12cmjg1/IDC_project/HARDWARE/usartx.c

#include "usartx.h"

PointDataProcessDef PointDataProcess[1200];//更新225个数据
LiDARFrameTypeDef Pack_Data;
PointDataProcessDef Dataprocess[1200];      //用于小车避障、跟随、走直线、ELE雷达避障的雷达数据

float Diff_Along_Distance_KP = -0.030f,Diff_Along_Distance_KD = -0.245f,Diff_Along_Distance_KI = -0.001f;	//差速小车走直线距离调整PID参数
float Akm_Along_Distance_KP = -0.115f*1000,Akm_Along_Distance_KD = -1000.245f*1000,Akm_Along_Distance_KI = -0.001f*1000;	//阿克曼走直线距离调整PID参数
float FourWheel_Along_Distance_KP = -0.115f*1000,FourWheel_Along_Distance_KD = -100.200f*1000,FourWheel_Along_Distance_KI = -0.001f*1000;	//四驱走直线距离调整PID参数
float Along_Distance_KP = 0.163f*1000,Along_Distance_KD = 0.123*1000,Along_Distance_KI = 0.001f*1000;	//麦轮和全向走直线距离调整PID参数

float Distance_KP = -0.150f,Distance_KD = -0.052f,Distance_KI = -0.001;	//跟随距离调整PID参数

float Follow_KP = -2.566f,Follow_KD = -1.368f,Follow_KI = -0.001f;  //转向PID
float Follow_KP_Akm = -0.550f,Follow_KD_Akm = -0.121f,Follow_KI_Akm = -0.001f;

/**************************************************************************
Function: Serial port 1 initialization
Input   : none
Output  : none
函数功能：串口1初始化
入口参数：无
返 回 值：无
**************************************************************************/
void uart1_init(u32 bound)
{  	 
	GPIO_InitTypeDef GPIO_InitStructure;
	USART_InitTypeDef USART_InitStructure;
	NVIC_InitTypeDef NVIC_InitStructure;
	
	RCC_AHB1PeriphClockCmd(RCC_AHB1Periph_GPIOA, ENABLE);	 //Enable the gpio clock //使能GPIO时钟
	RCC_APB2PeriphClockCmd(RCC_APB2Periph_USART1, ENABLE); //Enable the Usart clock //使能USART时钟

	GPIO_PinAFConfig(GPIOA,GPIO_PinSource9,GPIO_AF_USART1);	
	GPIO_PinAFConfig(GPIOA,GPIO_PinSource10 ,GPIO_AF_USART1);	 
	
	GPIO_InitStructure.GPIO_Pin = GPIO_Pin_9|GPIO_Pin_10;
	GPIO_InitStructure.GPIO_Mode=GPIO_Mode_AF;            //输出模式
	GPIO_InitStructure.GPIO_OType=GPIO_OType_PP;          //推挽输出
	GPIO_InitStructure.GPIO_Speed=GPIO_Speed_50MHz;       //高速50MHZ
	GPIO_InitStructure.GPIO_PuPd=GPIO_PuPd_UP;            //上拉
	GPIO_Init(GPIOA, &GPIO_InitStructure);  		          //初始化
	
  //UsartNVIC configuration //UsartNVIC配置
	NVIC_InitStructure.NVIC_IRQChannel = USART1_IRQn;
	//Preempt priority //抢占优先级
	NVIC_InitStructure.NVIC_IRQChannelPreemptionPriority=1 ;
	//Subpriority //子优先级
	NVIC_InitStructure.NVIC_IRQChannelSubPriority = 0;		
	//Enable the IRQ channel //IRQ通道使能
	NVIC_InitStructure.NVIC_IRQChannelCmd = ENABLE;	
  //Initialize the VIC register with the specified parameters 
	//根据指定的参数初始化VIC寄存器	
	NVIC_Init(&NVIC_InitStructure);	
	
  //USART Initialization Settings 初始化设置
	USART_InitStructure.USART_BaudRate = bound; //Port rate //串口波特率
	USART_InitStructure.USART_WordLength = USART_WordLength_8b; //The word length is 8 bit data format //字长为8位数据格式
	USART_InitStructure.USART_StopBits = USART_StopBits_1; //A stop bit //一个停止位
	USART_InitStructure.USART_Parity = USART_Parity_No; //Prosaic parity bits //无奇偶校验位
	USART_InitStructure.USART_HardwareFlowControl = USART_HardwareFlowControl_None; //No hardware data flow control //无硬件数据流控制
	USART_InitStructure.USART_Mode = USART_Mode_Rx | USART_Mode_Tx;	//Sending and receiving mode //收发模式
	USART_Init(USART1, &USART_InitStructure); //Initialize serial port 1 //初始化串口1
	
	USART_ITConfig(USART1, USART_IT_RXNE, ENABLE); //Open the serial port to accept interrupts //开启串口接受中断
	USART_Cmd(USART1, ENABLE);                     //Enable serial port 1 //使能串口1
}
/**************************************************************************
Function: Serial port 2 initialization
Input   : none
Output  : none
函数功能：串口2初始化
入口参数：无
返回  值：无
**************************************************************************/
void uart2_init(u32 bound)
{  	 
	GPIO_InitTypeDef GPIO_InitStructure;
	USART_InitTypeDef USART_InitStructure;
	NVIC_InitTypeDef NVIC_InitStructure;

	RCC_AHB1PeriphClockCmd(RCC_AHB1Periph_GPIOD, ENABLE);	 //Enable the gpio clock  //使能GPIO时钟
	RCC_APB1PeriphClockCmd(RCC_APB1Periph_USART2, ENABLE); //Enable the Usart clock //使能USART时钟
	
	GPIO_PinAFConfig(GPIOD,GPIO_PinSource5,GPIO_AF_USART2);	
	GPIO_PinAFConfig(GPIOD,GPIO_PinSource6 ,GPIO_AF_USART2);	 
	
	GPIO_InitStructure.GPIO_Pin = GPIO_Pin_5|GPIO_Pin_6;
	GPIO_InitStructure.GPIO_Mode=GPIO_Mode_AF;            //输出模式
	GPIO_InitStructure.GPIO_OType=GPIO_OType_PP;          //推挽输出
	GPIO_InitStructure.GPIO_Speed=GPIO_Speed_50MHz;       //高速50MHZ
	GPIO_InitStructure.GPIO_PuPd=GPIO_PuPd_UP;            //上拉
	GPIO_Init(GPIOD, &GPIO_InitStructure);  		          //初始化
	
	//UsartNVIC configuration //UsartNVIC配置
	NVIC_InitStructure.NVIC_IRQChannel = USART2_IRQn;
	//Preempt priority //抢占优先级
	NVIC_InitStructure.NVIC_IRQChannelPreemptionPriority=1 ;
	//Subpriority //子优先级
	NVIC_InitStructure.NVIC_IRQChannelSubPriority = 0;	
  //Enable the IRQ channel //IRQ通道使能	
	NVIC_InitStructure.NVIC_IRQChannelCmd = ENABLE;
  //Initialize the VIC register with the specified parameters 
	//根据指定的参数初始化VIC寄存器		
	NVIC_Init(&NVIC_InitStructure);	
	
	//USART Initialization Settings 初始化设置
	USART_InitStructure.USART_BaudRate = bound; //Port rate //串口波特率
	USART_InitStructure.USART_WordLength = USART_WordLength_8b; //The word length is 8 bit data format //字长为8位数据格式
	USART_InitStructure.USART_StopBits = USART_StopBits_1; //A stop bit //一个停止
	USART_InitStructure.USART_Parity = USART_Parity_No; //Prosaic parity bits //无奇偶校验位
	USART_InitStructure.USART_HardwareFlowControl = USART_HardwareFlowControl_None; //No hardware data flow control //无硬件数据流控制
	USART_InitStructure.USART_Mode = USART_Mode_Rx | USART_Mode_Tx;	//Sending and receiving mode //收发模式
	USART_Init(USART2, &USART_InitStructure);      //Initialize serial port 2 //初始化串口2
	
	USART_ITConfig(USART2, USART_IT_RXNE, ENABLE); //Open the serial port to accept interrupts //开启串口接受中断
	USART_Cmd(USART2, ENABLE);                     //Enable serial port 2 //使能串口2 
}
/**************************************************************************
Function: Serial port 5 initialization
Input   : none
Output  : none
函数功能：串口5初始化
入口参数：无
返回  值：无
**************************************************************************/
void uart5_init(u32 bound)
{  	 
  GPIO_InitTypeDef GPIO_InitStructure;
	USART_InitTypeDef USART_InitStructure;
	NVIC_InitTypeDef NVIC_InitStructure;
	
	//PC12 TX
	RCC_AHB1PeriphClockCmd(RCC_AHB1Periph_GPIOC, ENABLE);	 //Enable the gpio clock  //使能GPIO时钟
	//PD2 RX
	RCC_AHB1PeriphClockCmd(RCC_AHB1Periph_GPIOD, ENABLE);	 //Enable the gpio clock  //使能GPIO时钟
  RCC_APB1PeriphClockCmd(RCC_APB1Periph_UART5, ENABLE); //Enable the Usart clock //使能USART时钟

	GPIO_PinAFConfig(GPIOC,GPIO_PinSource12,GPIO_AF_UART5);	
	GPIO_PinAFConfig(GPIOD,GPIO_PinSource2 ,GPIO_AF_UART5);	 
	
	GPIO_InitStructure.GPIO_Pin = GPIO_Pin_12;
	GPIO_InitStructure.GPIO_Mode=GPIO_Mode_AF;            //输出模式
	GPIO_InitStructure.GPIO_OType=GPIO_OType_PP;          //推挽输出
	GPIO_InitStructure.GPIO_Speed=GPIO_Speed_50MHz;       //高速50MHZ
	GPIO_InitStructure.GPIO_PuPd=GPIO_PuPd_UP;            //上拉
	GPIO_Init(GPIOC, &GPIO_InitStructure);  		          //初始化

	GPIO_InitStructure.GPIO_Pin = GPIO_Pin_2;
	GPIO_InitStructure.GPIO_Mode=GPIO_Mode_AF;            //输出模式
	GPIO_InitStructure.GPIO_OType=GPIO_OType_PP;          //推挽输出
	GPIO_InitStructure.GPIO_Speed=GPIO_Speed_50MHz;       //高速50MHZ
	GPIO_InitStructure.GPIO_PuPd=GPIO_PuPd_UP;            //上拉
	GPIO_Init(GPIOD, &GPIO_InitStructure);  		          //初始化
	
  //UsartNVIC configuration //UsartNVIC配置
  NVIC_InitStructure.NVIC_IRQChannel = UART5_IRQn;
	//Preempt priority //抢占优先级
	NVIC_InitStructure.NVIC_IRQChannelPreemptionPriority=2 ;
	//Preempt priority //抢占优先级
	NVIC_InitStructure.NVIC_IRQChannelSubPriority = 0;		
	//Enable the IRQ channel //IRQ通道使能	
	NVIC_InitStructure.NVIC_IRQChannelCmd = ENABLE;	
  //Initialize the VIC register with the specified parameters 
	//根据指定的参数初始化VIC寄存器		
	NVIC_Init(&NVIC_InitStructure);
	
  //USART Initialization Settings 初始化设置
	USART_InitStructure.USART_BaudRate = bound; //Port rate //串口波特率
	USART_InitStructure.USART_WordLength = USART_WordLength_8b; //The word length is 8 bit data format //字长为8位数据格式
	USART_InitStructure.USART_StopBits = USART_StopBits_1; //A stop bit //一个停止
	USART_InitStructure.USART_Parity = USART_Parity_No; //Prosaic parity bits //无奇偶校验位
	USART_InitStructure.USART_HardwareFlowControl = USART_HardwareFlowControl_None; //No hardware data flow control //无硬件数据流控制
	USART_InitStructure.USART_Mode = USART_Mode_Rx | USART_Mode_Tx;	//Sending and receiving mode //收发模式
  USART_Init(UART5, &USART_InitStructure);      //Initialize serial port 5 //初始化串口5
  USART_ITConfig(UART5, USART_IT_RXNE, ENABLE); //Open the serial port to accept interrupts //开启串口接受中断
  USART_Cmd(UART5, ENABLE);                     //Enable serial port 5 //使能串口5
}
/**************************************************************************
Function: Serial port 1 receives interrupted
Input   : none
Output  : none
函数功能：串口1接收中断
入口参数：无
返 回 值：无
**************************************************************************/
int USART1_IRQHandler(void)
{	
	if(USART_GetITStatus(USART1, USART_IT_RXNE) != RESET) //Check if data is received //判断是否接收到数据
	{
//		u8 Usart_Receive;		
//		Usart_Receive = 
		USART_ReceiveData(USART1); //Read the data //读取数据	
	}
	return 0;	
}
/**************************************************************************
Function: Refresh the OLED screen
Input   : none
Output  : none
函数功能：串口2接收中断
入口参数：无
返回  值：无
**************************************************************************/
int USART2_IRQHandler(void)
{	
	static int temp_count = 0;				//用于记录前进的指令的次数，第一次连接蓝牙的时候需要用到
	int Usart_Receive;
	if(USART_GetITStatus(USART2, USART_IT_RXNE) != RESET) //Check if data is received //判断是否接收到数据
	{	      
		static u8 Flag_PID,i,j,Receive[50];
		static float Data;
				
		Usart_Receive=USART2->DR; //Read the data //读取数据
		//抓包方法和使用
		if(AT_Command_Capture(Usart_Receive)) return 1;
	  
		if(Usart_Receive==0x4B) 
			//Enter the APP steering control interface
		  //进入APP转向控制界面
			Turn_Flag=1;   
	  else	if(Usart_Receive==0x49||Usart_Receive==0x4A) 
      // Enter the APP direction control interface		
			//进入APP方向控制界面	
			Turn_Flag=0;	
		
		if(Turn_Flag==0) 
		{
			//App rocker control interface command
			//APP摇杆控制界面命令
			if(Usart_Receive>=0x41&&Usart_Receive<=0x48)  
			{	
				Mode=APP_Control_Mode;
				Flag_Direction=Usart_Receive-0x40;
			}
			else	if(Usart_Receive<=8)   
			{			
				Flag_Direction=Usart_Receive;
			}	
			else  Flag_Direction=0;
		}
		else if(Turn_Flag==1)
		{
			//APP steering control interface command
			//APP转向控制界面命令
			if     (Usart_Receive==0x43) Flag_Left=0,Flag_Right=1; //Right rotation //右自转
			else if(Usart_Receive==0x47) Flag_Left=1,Flag_Right=0; //Left rotation  //左自转
			else                         Flag_Left=0,Flag_Right=0;
			if     (Usart_Receive==0x41||Usart_Receive==0x45) 
			{
				if((++temp_count) == 5)					//需要连续发送5次前进的指令，上拉转盘一段时间可开始app控制
				{
					temp_count = 0;
					APP_ON_Flag = RC_ON;		
					PS2_ON_Flag = RC_OFF;
					Mode=APP_Control_Mode;
				}
				Flag_Direction=Usart_Receive-0x40;
			}
			else  Flag_Direction=0;
		}
		if(Usart_Receive==0x58)  RC_Velocity=RC_Velocity+100; //Accelerate the keys, +100mm/s //加速按键，+100mm/s
		if(Usart_Receive==0x59)  RC_Velocity=RC_Velocity-100; //Slow down buttons,   -100mm/s //减速按键，-100mm/s
	  
	if(Usart_Receive=='a')	RC_Lidar_Avoid_FLAG=!RC_Lidar_Avoid_FLAG;
	 // The following is the communication with the APP debugging interface
	 //以下是与APP调试界面通讯
	 if(Usart_Receive==0x7B) Flag_PID=1;   //The start bit of the APP parameter instruction //APP参数指令起始位
	 if(Usart_Receive==0x7D) Flag_PID=2;   //The APP parameter instruction stops the bit    //APP参数指令停止位

	 if(Flag_PID==1) //Collect data //采集数据
	 {
		Receive[i]=Usart_Receive;
		i++;
	 }
	 if(Flag_PID==2) //Analyze the data //分析数据
	 {
			if(Receive[3]==0x50) 	 PID_Send=1;
			else  if(Receive[1]!=0x23) 
      {								
				for(j=i;j>=4;j--)
				{
					Data+=(Receive[j-1]-48)*pow(10,i-j);
				}
				
				if(Mode == APP_Control_Mode)
					{
					switch(Receive[1])			//APP电机调参
					 {
						 case 0x30:  RC_Velocity=Data;break;
						 case 0x31:  Velocity_KP=Data;break;
						 case 0x32:  Velocity_KI=Data;break;
						 case 0x33:  break;
						 case 0x34:  break;
						 case 0x35:  break;
						 case 0x36:  break;
						 case 0x37:  break;
						 case 0x38:  break; 				
					 } 
					}
					else if(Mode == ELE_Line_Patrol_Mode)		//电磁巡线z轴速度调参
					{
					switch(Receive[1])
					 {
						 case 0x30:  RC_Velocity_ELE=Data;break;
						 case 0x31:  ELE_KP=Data;break;
						 case 0x32:  ELE_KI=Data;break;
						 case 0x33:  break;
						 case 0x34:  break;
						 case 0x35:  break;
						 case 0x36:  break;
						 case 0x37:  break;
						 case 0x38:  break; 				
					 } 
					}
					else 	if(Mode == CCD_Line_Patrol_Mode)									//CCD巡线z轴速度调参
					{
					switch(Receive[1])
					 {
						 case 0x30:  RC_Velocity_CCD=Data;break;
						 case 0x31:  CCD_KP=Data;break;
						 case 0x32:  CCD_KI=Data;break;
						 case 0x33:  break;
						 case 0x34:  break;
						 case 0x35:  break;
						 case 0x36:  break;
						 case 0x37:  break;
						 case 0x38:  break; 				
					 } 
					}
					else if(Mode == Lidar_Along_Mode)
					{
						switch(Receive[1])
						{
						 case 0x30:  Along_Distance_KP=Data;break;
						 case 0x31:  Along_Distance_KD=Data;break;
						 case 0x32:  Along_Distance_KI=Data;break;
						 case 0x33:  break;
						 case 0x34:  break;
						 case 0x35:  break;
						 case 0x36:  break;
						 case 0x37:  break;
						 case 0x38:  break; 	
						}
					}
					else if(Mode == Lidar_Follow_Mode)
					{
						switch(Receive[1])
						{
						 case 0x30:  break;
						 case 0x31:  break;
						 case 0x32:  break;
						 case 0x33:  break;
						 case 0x34:  break;
						 case 0x35:  break;
						 case 0x36:  break;
						 case 0x37:  break;
						 case 0x38:  break; 	
						}
					}
				}		
      //Relevant flag position is cleared			
      //相关标志位清零			
			Flag_PID=0;
			i=0;
			j=0;
			Data=0;
			memset(Receive, 0, sizeof(u8)*50); //Clear the array to zero//数组清零
	 }
   if(RC_Velocity<0)   RC_Velocity=0; 
	 if(RC_Velocity_CCD<0)   RC_Velocity_CCD=0;
	 if(RC_Velocity_ELE<0)   RC_Velocity_ELE=0;		 
  }
  return 0;	
}

/**************************************************************************
Function: Serial port 5 receives interrupted
Input   : none
Output  : none
函数功能：串口5接收中断
入口参数：无
返回  值：无
**************************************************************************/
int UART5_IRQHandler(void)
{	
	static u8 state = 0;//状态位	
	static u8 crc_sum = 0;//校验和
	static u8 cnt = 0;//用于一帧16个点的计数
	u8 temp_data;

	if(USART_GetITStatus(UART5, USART_IT_RXNE) != RESET) //接收到数据
	{	
		//USART_ClearITPendingBit(UART5, USART_IT_RXNE);
		temp_data=USART_ReceiveData(UART5);	
		switch(state)
		{
			case 0:
				if(temp_data == HEADER_0)//头固定
				{
					Pack_Data.header_0= temp_data;
					state++;
					//校验
					crc_sum += temp_data;
				} else state = 0,crc_sum = 0;
				break;
			case 1:
				if(temp_data == HEADER_1)//头固定
				{
					Pack_Data.header_1 = temp_data;
					state++;
					crc_sum += temp_data;
				} else state = 0,crc_sum = 0;
				break;
			case 2:
				if(temp_data == Length_)//字长固定
				{
					Pack_Data.ver_len = temp_data;
					state++;
					crc_sum += temp_data;
				} else state = 0,crc_sum = 0;
				break;
			case 3:
				Pack_Data.speed_h = temp_data;//速度高八位
				state++;
				crc_sum += temp_data;			
				break;
			case 4:
				Pack_Data.speed_l = temp_data;//速度低八位
				state++;
				crc_sum += temp_data;
				break;
			case 5:
				Pack_Data.start_angle_h = temp_data;//开始角度高八位
				state++;
				crc_sum += temp_data;
				break;
			case 6:
				Pack_Data.start_angle_l = temp_data;//开始角度低八位
				state++;
				crc_sum += temp_data;
				break;
			
			case 7:case 10:case 13:case 16:
			case 19:case 22:case 25:case 28:
			case 31:case 34:case 37:case 40:
			case 43:case 46:case 49:case 52:
				
			case 55:case 58:case 61:case 64:
			case 67:case 70:case 73:case 76:
			case 79:case 82:case 85:case 88:
			case 91:case 94:case 97:case 100:
				Pack_Data.point[cnt].distance_h = temp_data & 0x7f ;//16个点的距离数据，高字节
				state++;
				crc_sum += temp_data;
				break;
			
			case 8:case 11:case 14:case 17:
			case 20:case 23:case 26:case 29:
			case 32:case 35:case 38:case 41:
			case 44:case 47:case 50:case 53:
				
			case 56:case 59:case 62:case 65:
			case 68:case 71:case 74:case 77:
			case 80:case 83:case 86:case 89:
			case 92:case 95:case 98:case 101:
				Pack_Data.point[cnt].distance_l = temp_data;//16个点的距离数据，低字节
				state++;
				crc_sum += temp_data;
				break;
			
			case 9:case 12:case 15:case 18:
			case 21:case 24:case 27:case 30:
			case 33:case 36:case 39:case 42:
			case 45:case 48:case 51:case 54:
				
			case 57:case 60:case 63:case 66:
			case 69:case 72:case 75:case 78:
			case 81:case 84:case 87:case 90:
			case 93:case 96:case 99:case 102:
				Pack_Data.point[cnt].Strong = temp_data;//16个点的强度数据
				state++;
				crc_sum += temp_data;
				cnt++;
				break;
			case 103:case 104:
				state++;
				crc_sum += temp_data;
				cnt++;
				break;
			case 105:
				Pack_Data.end_angle_h = temp_data;//结束角度的高八位
				state++;
				crc_sum += temp_data;			
				break;
			case 106:
				Pack_Data.end_angle_l = temp_data;//结束角度的低八位
				state++;
				crc_sum += temp_data;
				break;
			case 107:
				Pack_Data.crc = temp_data;//校验
				state = 0;
				cnt = 0;
				if(crc_sum == Pack_Data.crc)
				{
					data_process();//数据处理，校验正确不断刷新存储的数据	
				}
				else 
				{
					memset(&Pack_Data,0,sizeof(Pack_Data));//清零
				}
				crc_sum = 0;//校验和清零
				break;
			default: break;
		}
	}		
  return 0;	
}

/**************************************************************************
Function: data_process
Input   : none
Output  : none
函数功能：数据处理函数
入口参数：无
返回  值：无
**************************************************************************/
//完成一帧接收后进行处理
int data_cnt = 0;
void data_process(void) //数据处理
{
	int m;
	u32 distance_sum[32]={0};//2个点的距离和的数组
	float start_angle = (((u16)Pack_Data.start_angle_h<<8)+Pack_Data.start_angle_l)/100.0;//计算32个点的开始角度
	float end_angle = (((u16)Pack_Data.end_angle_h<<8)+Pack_Data.end_angle_l)/100.0;//计算32个点的结束角度
	float area_angle[32]={0};
	Lidar_Success_Receive_flag=1;Lidar_flag_count=0;//雷达在线标志位处理
	if(start_angle>end_angle)//结束角度和开始角度被0度分割的情况
		end_angle +=360;
	
	for(m=0;m<32;m++)
	{
		area_angle[m]=start_angle+(end_angle-start_angle)/32*m;
		if(area_angle[m]>360)  area_angle[m] -=360;
		
		distance_sum[m] +=((u16)Pack_Data.point[m].distance_h<<8)+Pack_Data.point[m].distance_l;//数据高低8位合并

		Dataprocess[data_cnt].angle=area_angle[m];
		Dataprocess[data_cnt++].distance=distance_sum[m];  //一帧数据为32个点
		if(data_cnt == 1152) data_cnt = 0;
	}
	
		
}

/**************************************************************************
Function: After the top 8 and low 8 figures are integrated into a short type data, the unit reduction is converted
Input   : 8 bits high, 8 bits low
Output  : The target velocity of the robot on the X/Y/Z axis
函数功能：将上位机发过来目标前进速度Vx、目标角速度Vz，转换为阿克曼小车的右前轮转角
入口参数：目标前进速度Vx、目标角速度Vz，单位：m/s，rad/s
返回  值：阿克曼小车的右前轮转角，单位：rad
**************************************************************************/
float Vz_to_Akm_Angle(float Vx, float Vz)
{
	float R, AngleR, Min_Turn_Radius;
	//float AngleL;
	
	//Ackermann car needs to set minimum turning radius
	//If the target speed requires a turn radius less than the minimum turn radius,
	//This will greatly improve the friction force of the car, which will seriously affect the control effect
	//阿克曼小车需要设置最小转弯半径
	//如果目标速度要求的转弯半径小于最小转弯半径，
	//会导致小车运动摩擦力大大提高，严重影响控制效果
	Min_Turn_Radius=MINI_AKM_MIN_TURN_RADIUS;
	
	if(Vz!=0 && Vx!=0)
	{
		//If the target speed requires a turn radius less than the minimum turn radius
		//如果目标速度要求的转弯半径小于最小转弯半径
		if(float_abs(Vx/Vz)<=Min_Turn_Radius)
		{
			//Reduce the target angular velocity and increase the turning radius to the minimum turning radius in conjunction with the forward speed
			//降低目标角速度，配合前进速度，提高转弯半径到最小转弯半径
			if(Vz>0)
				Vz= float_abs(Vx)/(Min_Turn_Radius);
			else	
				Vz=-float_abs(Vx)/(Min_Turn_Radius);	
		}		
		R=Vx/Vz;
		//AngleL=atan(Axle_spacing/(R-0.5*Wheel_spacing));
		AngleR=atan(Axle_spacing/(R+0.5f*Wheel_spacing));
	}
	else
	{
		AngleR=0;
	}
	
	return AngleR;
}
/**************************************************************************
Function: After the top 8 and low 8 figures are integrated into a short type data, the unit reduction is converted
Input   : 8 bits high, 8 bits low
Output  : The target velocity of the robot on the X/Y/Z axis
函数功能：将上位机发过来的高8位和低8位数据整合成一个short型数据后，再做单位还原换算
入口参数：高8位，低8位
返回  值：机器人X/Y/Z轴的目标速度
**************************************************************************/
float XYZ_Target_Speed_transition(u8 High,u8 Low)
{
	//Data conversion intermediate variable
	//数据转换的中间变量
	short transition; 
	
	//将高8位和低8位整合成一个16位的short型数据
	//The high 8 and low 8 bits are integrated into a 16-bit short data
	transition=((High<<8)+Low); 
	return 
		transition/1000+(transition%1000)*0.001; //Unit conversion, mm/s->m/s //单位转换, mm/s->m/s						
}
/**************************************************************************
Function: Serial port 1 sends data
Input   : The data to send
Output  : none
函数功能：串口1发送数据
入口参数：要发送的数据
返回  值：无
**************************************************************************/
void usart1_send(u8 data)
{
	USART1->DR = data;
	while((USART1->SR&0x40)==0);	
}
/**************************************************************************
Function: Serial port 2 sends data
Input   : The data to send
Output  : none
函数功能：串口2发送数据
入口参数：要发送的数据
返回  值：无
**************************************************************************/
void usart2_send(u8 data)
{
	USART2->DR = data;
	while((USART2->SR&0x40)==0);	
}

/**************************************************************************
Function: Serial port 5 sends data
Input   : The data to send
Output  : none
函数功能：串口5发送数据
入口参数：要发送的数据
返回  值：无
**************************************************************************/
void usart5_send(u8 data)
{
	UART5->DR = data;
	while((UART5->SR&0x40)==0);	
}
/**************************************************************************
Function: Calculates the check bits of data to be sent/received
Input   : Count_Number: The first few digits of a check; Mode: 0-Verify the received data, 1-Validate the sent data
Output  : Check result
函数功能：计算要发送/接收的数据校验结果
入口参数：Count_Number：校验的前几位数；Mode：0-对接收数据进行校验，1-对发送数据进行校验
返回  值：校验结果
**************************************************************************/
//u8 Check_Sum(unsigned char Count_Number,unsigned char Mode)
//{
//	unsigned char check_sum=0,k;
//	
//	//Validate the data to be sent
//	//对要发送的数据进行校验
//	if(Mode==1)
//	for(k=0;k<Count_Number;k++)
//	{
//	check_sum=check_sum^Send_Data.buffer[k];
//	}
//	
//	//Verify the data received
//	//对接收到的数据进行校验
//	if(Mode==0)
//	for(k=0;k<Count_Number;k++)
//	{
//	check_sum=check_sum^Receive_Data.buffer[k];
//	}
//	return check_sum;
//}


//蓝牙AT指令抓包，防止指令干扰到机器人正常的蓝牙通信
u8 AT_Command_Capture(u8 uart_recv)
{
	/*
	蓝牙链接时发送的字符，00:11:22:33:44:55为蓝牙的MAC地址
	+CONNECTING<<00:11:22:33:44:55\r\n
	+CONNECTED\r\n
	共44个字符
	
	蓝牙断开时发送的字符
	+DISC:SUCCESS\r\n
	+READY\r\n
	+PAIRABLE\r\n
	共34个字符
	\r -> 0x0D
	\n -> 0x0A
	*/
	
	static u8 pointer = 0; //蓝牙接受时指针记录器
	static u8 bt_line = 0; //表示现在在第几行
	static u8 disconnect = 0;
	static u8 connect = 0;
	
	//断开连接
	static char* BlueTooth_Disconnect[3]={"+DISC:SUCCESS\r\n","+READY\r\n","+PAIRABLE\r\n"};
	
	//开始连接
	static char* BlueTooth_Connect[2]={"+CONNECTING<<00:00:00:00:00:00\r\n","+CONNECTED\r\n"};


	//特殊标识符，开始警惕(使用时要-1)
	if(uart_recv=='+') 
	{
		bt_line++,pointer=0; //收到‘+’，表示切换了行数	
		disconnect++,connect++;
		return 1;//抓包，禁止控制
	}

	if(bt_line!=0) 
	{	
		pointer++;

		//开始追踪数据是否符合断开的特征，符合时全部屏蔽，不符合时取消屏蔽
		if(uart_recv == BlueTooth_Disconnect[bt_line-1][pointer])
		{
			disconnect++;
			if(disconnect==34) disconnect=0,connect=0,bt_line=0,pointer=0;
			return 1;//抓包，禁止控制
		}			

		//追踪连接特征 (bt_line==1&&connect>=13)区段是蓝牙MAC地址，每一个蓝牙MAC地址都不相同，所以直接屏蔽过去
		else if(uart_recv == BlueTooth_Connect[bt_line-1][pointer] || (bt_line==1&&connect>=13) )
		{		
			connect++;
			if(connect==44) connect=0,disconnect=0,bt_line=0,pointer=0;		
			return 1;//抓包，禁止控制
		}	

		//在抓包期间收到其他命令，停止抓包
		else
		{
			disconnect = 0;
			connect = 0;
			bt_line = 0;		
			pointer = 0;
			return 0;//非禁止数据，可以控制
		}			
	}
	
	return 0;//非禁止数据，可以控制
}

//软复位进BootLoader区域
void _System_Reset_(u8 uart_recv)
{
	static u8 res_buf[5];
	static u8 res_count=0;
	
	res_buf[res_count]=uart_recv;
	
	if( uart_recv=='r'||res_count>0 )
		res_count++;
	else
		res_count = 0;
	
	if(res_count==5)
	{
		res_count = 0;
		//接受到上位机请求的复位字符“reset”，执行软件复位
		if( res_buf[0]=='r'&&res_buf[1]=='e'&&res_buf[2]=='s'&&res_buf[3]=='e'&&res_buf[4]=='t' )
		{
			NVIC_SystemReset();//进行软件复位，复位后执行 BootLoader 程序
		}
	}
}
