12cmjg1/IDC_project/HARDWARE/timer.c

#include "timer.h"

void TIM8_SERVO_Init(u16 arr,u16 psc)
{
	GPIO_InitTypeDef GPIO_InitStructure;           //IO
	TIM_TimeBaseInitTypeDef TIM_TimeBaseStructure; //定时器
	TIM_OCInitTypeDef  TIM_OCInitStructure;        //PWM输出
	
	RCC_APB2PeriphClockCmd(RCC_APB2Periph_TIM8,ENABLE);  	//TIM1时钟使能    
	RCC_AHB1PeriphClockCmd(RCC_AHB1Periph_GPIOC, ENABLE); 	//使能PORTE时钟	
		
	GPIO_InitStructure.GPIO_Mode=GPIO_Mode_AF; 
	GPIO_InitStructure.GPIO_Pin = GPIO_Pin_9;
  GPIO_InitStructure.GPIO_Speed=GPIO_Speed_100MHz; 	
	GPIO_InitStructure.GPIO_OType=GPIO_OType_PP;
	GPIO_InitStructure.GPIO_PuPd=GPIO_PuPd_UP;
	GPIO_Init(GPIOC, &GPIO_InitStructure);
	 
	GPIO_PinAFConfig(GPIOC,GPIO_PinSource9,GPIO_AF_TIM8); 


	/*** Initialize timer 1 || 初始化定时器1 ***/
	//Set the counter to automatically reload //设定计数器自动重装值 
	TIM_TimeBaseStructure.TIM_Period = arr; 
	//Pre-divider //预分频器 
	TIM_TimeBaseStructure.TIM_Prescaler = psc; 	
	//Set the clock split: TDTS = Tck_tim //设置时钟分割:TDTS = Tck_tim
	TIM_TimeBaseStructure.TIM_ClockDivision = TIM_CKD_DIV1; 
	//TIM up count mode //TIM向上计数模式	
	TIM_TimeBaseStructure.TIM_CounterMode = TIM_CounterMode_Up; 
	//Initializes the timebase unit for TIMX based on the parameter specified in TIM_TimeBaseInitStruct
	//根据TIM_TimeBaseInitStruct中指定的参数初始化TIMx的时间基数单位
	TIM_TimeBaseInit(TIM8, &TIM_TimeBaseStructure); 


	//-----------舵机初始化-----------//
	//Select Timer mode :TIM Pulse Width Modulation mode 1
  //选择定时器模式:TIM脉冲宽度调制模式1
 	TIM_OCInitStructure.TIM_OCMode = TIM_OCMode_PWM1; 
	//Compare output enablement
	//比较输出使能
	TIM_OCInitStructure.TIM_OutputState = TIM_OutputState_Enable; 
	//Set the pulse value of the capture comparison register to be loaded
	//设置待装入捕获比较寄存器的脉冲值
	TIM_OCInitStructure.TIM_Pulse = 0; 
  //Output polarity :TIM output polarity is higher	
  //输出极性:TIM输出比较极性高	
	TIM_OCInitStructure.TIM_OCPolarity = TIM_OCPolarity_High;   
	TIM_OCInitStructure.TIM_OCIdleState = TIM_OCIdleState_Reset;   
	
	//Initialize the peripheral TIMX based on the parameter specified in TIM_OCINITSTRUCT
  //根据TIM_OCInitStruct中指定的参数初始化外设TIMx	
	TIM_OC4Init(TIM8, &TIM_OCInitStructure); 
	//Channel preload enable
	//通道预装载使能	 
	TIM_OC4PreloadConfig(TIM8, TIM_OCPreload_Enable);
	//-----------舵机初始化-----------//
	TIM_ITConfig(TIM8, TIM_IT_CC4,	DISABLE);
	TIM_CtrlPWMOutputs(TIM8,ENABLE); 	
	//Enable timer //使能定时器
	TIM_Cmd(TIM8, ENABLE); 		 
}
