12cmjg1/IDC_project/(commit log)

2026-05-27 IMU加入
2026-05-30 Tune actuator and open-loop climb control
